SebastianJay/chECEckm8/(list of files, drawings)

Other design files:
schematics/master_board.ms14
