SebastianJay/chECEckm8/ccs-workspace/checkmate/board_state.h

/*
 * board_state.h
 *
 * Deals with reading from sensor network and determining
 * when a piece movement has been made.
 *
 *  Created on: Oct 18, 2016
 *      Author: Jay
 */

#ifndef BOARD_STATE_H_
#define BOARD_STATE_H_

/** Defines **/
#define BOARD_ROWS 8
#define BOARD_COLS 8
#define MOVES_BUFFER_LENGTH 8
#define MOVES_CHANGE_THRESHOLD 8
#define MOVES_CHANGE_BUFFER_WINDOW	10

#define MUX_SELECT1_PORT	GPIO_PORT_P5
#define MUX_SELECT1_PIN		GPIO_PIN5
#define MUX_SELECT2_PORT	GPIO_PORT_P5
#define MUX_SELECT2_PIN		GPIO_PIN4
#define MUX_SELECT3_PORT	GPIO_PORT_P4
#define MUX_SELECT3_PIN		GPIO_PIN7
#define MUX_SELECT4_PORT	GPIO_PORT_P4
#define MUX_SELECT4_PIN		GPIO_PIN5

#define MUX_READ1_PORT		GPIO_PORT_P4
#define MUX_READ1_PIN		GPIO_PIN4
#define MUX_READ2_PORT		GPIO_PORT_P4
#define MUX_READ2_PIN		GPIO_PIN2
#define MUX_READ3_PORT		GPIO_PORT_P4
#define MUX_READ3_PIN		GPIO_PIN0
#define MUX_READ4_PORT		GPIO_PORT_P6
#define MUX_READ4_PIN		GPIO_PIN1

#define TRUE 				1
#define FALSE 				0
#define ERROR 				-1
#define GAMEOVER_NO_MOVE	2
#define GAMEOVER_WITH_MOVE	3

#define STATUS_NORMAL		1
#define STATUS_INVALID		0

/** Typedefs **/
typedef struct {
	// row and col of piece location
	signed char r;
	signed char c;
	// flag for direction of change (piece coming off or on)
	char dir;

} piece_change;

typedef struct {
	// row and col of piece start location
	signed char rStart;
	signed char cStart;
	// row and col of piece end location
	signed char rEnd;
	signed char cEnd;
} piece_movement;

typedef struct {
	// most recent valid state
	char validState[BOARD_ROWS][BOARD_COLS];
	// buffer for current state of board
	char currentState[BOARD_ROWS][BOARD_COLS];
	// buffer for most recent read straight from sensor network
	char nextState[BOARD_ROWS][BOARD_COLS];
	// counters for each board space of number of frames state has changed
	char changeStateCounter[BOARD_ROWS][BOARD_COLS];
	char changeStateBuffer[BOARD_ROWS][BOARD_COLS][MOVES_CHANGE_BUFFER_WINDOW];
	char changeStateBufferIndex;

	// keep track of moves player has made
	piece_change moveList[MOVES_BUFFER_LENGTH];
	char moveListIndex;
} chess_board;

/** Globals **/
chess_board gBoardState;

/** Functions **/
// do any setup to read from the sensor network
void initSensors();

// compares nextState against currentState and update changeStateCounter
void updateChangeStateCounter();

// for changes that meet threshold, update currentState and optionally update moveList
void updateCurrentState(char updateMoveList);

// in the invalid state, compare currentState against validState and return true if identical
signed char isCurrentStateValid();
// update currentState with the given parameter
void updateCurrentStateWithMove(piece_movement move);
// transfer contents of currentState into validState
void copyCurrentStateIntoValid();

// sets the LED to the appropriate state (on if invalid, off if valid)
void setStatusLed(signed char status);

// examine moveList and return TRUE and write to *move if chess move detected, FALSE otherwise
// can also return ERROR if an invalid move is detected from MSP
signed char constructPieceMovement(piece_movement* move);

// read from sensor network into nextState
void readNextState();

#endif /* BOARD_STATE_H_ */
