SebastianJay/chECEckm8/ccs-workspace/checkmate/motors.h

/*
 * motors.h
 *
 * Deals with interfacing with the XY table motors and servo
 *
 *  Created on: Oct 19, 2016
 *      Author: Jay
 */

#ifndef MOTORS_H_
#define MOTORS_H_

#include "driverlib.h"
#include "board_state.h"

/** Defines **/
#define SERVO_DELAY_BETWEEN_PULSE 	24000	// low ticks between pulses, 20 ms
// according to datasheet the full range is spanned by 0.75 ms (900 ticks) and 2.25 ms (2700 ticks) pulses
// in practice it seems we need to stretch these out a bit further
#define SERVO_PULSE_WIDTH_1			2225	 // high ticks for engage, 1.5 ms
#define SERVO_PULSE_WIDTH_2			1175 // high ticks for disengage, 2.25 ms

// delays associated with motor components
#define ONE_SECOND_TICKS	12000000
#define SERVO_ENGAGE_DELAY	ONE_SECOND_TICKS * 3 / 2	// ticks after switching the servo state (1.5 s)
#define MOTOR_MOVE_DELAY	ONE_SECOND_TICKS / 2	// ticks after completing a motor movement (0.5 s)
#define MOTOR_AWAKE_DELAY	ONE_SECOND_TICKS / 250	// ticks after awaking motor so it can "boot" (4 ms)

#define MOTOR_SPEED_SLOW	0
#define MOTOR_SPEED_FAST	1

/** default (SLOW) motor values **/
// these values are derived to apply 6400 Hz square wave to STEP
#define X_STEP_TICKS 	938		// ticks to wait in high or low for x stepping
#define Y_STEP_TICKS 	938		// ticks to wait in high or low for y stepping

/** FAST motor values **/
#define X_STEP_TICKS_FAST	469
#define Y_STEP_TICKS_FAST	469

// STEPS_PER_SPACE = steps needed to travel one chess board space (3.75 in)
// to calculate this, choose an arbitrary step count and measure its corresponding distance
//  then use a ratio with your desired distance to find the required step count
#define STEPS_PER_SPACE			10196

#define STEPS_COLUMN_A 5098
#define STEPS_ROW_ONE 3739

// ports and pins for motor control
#define X_STEP_PORT		GPIO_PORT_P2
#define X_STEP_PIN		GPIO_PIN5
#define X_DIR_PORT		GPIO_PORT_P3
#define X_DIR_PIN		GPIO_PIN0
#define X_SLEEP_PORT	GPIO_PORT_P5
#define X_SLEEP_PIN		GPIO_PIN7

#define Y_STEP_PORT		GPIO_PORT_P2
#define Y_STEP_PIN		GPIO_PIN7
#define Y_DIR_PORT		GPIO_PORT_P2
#define Y_DIR_PIN		GPIO_PIN6
#define Y_SLEEP_PORT	GPIO_PORT_P5
#define Y_SLEEP_PIN		GPIO_PIN6

#define X_HOMING_BUTTON_PORT	GPIO_PORT_P6
#define X_HOMING_BUTTON_PIN		GPIO_PIN6

#define Y_HOMING_BUTTON_PORT	GPIO_PORT_P6
#define Y_HOMING_BUTTON_PIN		GPIO_PIN7

#define SERVO_SIGNAL_PORT	GPIO_PORT_P2
#define SERVO_SIGNAL_PIN	GPIO_PIN4

// macro functions
#define ABSVAL(x)		((x) >= 0 ? (x) : -(x))
#define MAXVAL(x, y)	((x) > (y) ? (x) : (y))

/** Structs **/
typedef struct {
	signed char r;
	signed char c;
} tableCursor;

/** Globals **/
tableCursor gTableCursor;
int gCaptureIndex;
int gSpeedSetting;

/** Functions **/
// do any setup to send commands to motor driver
void initMotors();

// use the servo to move the magnet into position
void engageMagnet();
// use the servo to move the magnet out of position
void disengageMagnet();

void moveToButtons();

// move table cursor to (0, 0), the bottom left corner
void moveToHome();
// move table cursor to (row, column), with option of using servo
void moveRC(int row, int column, int engage);

// execute 1 or 2 moves sent from the chess server using the motors, choosing to use corners intelligently
void process_moves(piece_movement move1, piece_movement move2);
// move from one location to another, with option of using servo to magnetically drag piece
//  useCorner determines whether to move between tiles
void move(piece_movement movement, int engage, int useCorner);
// helpers to accomplish move()
void moveX(int num_spaces);		// moves along the x axis (between columns)
void moveY(int num_spaces);		// moves along the y axis (between rows)
void moveXY(int x_num_spaces, int y_num_spaces); 	// moves diagonally (between col and row at once)
void moveHalfTile(int xdir, int ydir);		// moves a half tile in directions specified by signs of parameters
void stepX();		// sends STEP to x axis motor
void stepY();		// sends STEP to y axis motor

// DEBUG functions
// transitions between engaged and disengaged states forever
void debugServoLoop();
// does some simple motor movement
void debugMotorDemo();
// tests whether MSP can read from button
void debugButtonDemo();

#endif /* MOTORS_H_ */
