SebastianJay/chECEckm8/(commit log)

2016-09-21 prelim uart code from site
2016-10-24 uart hello world communication
2016-11-07 servo two state code
2016-11-12 change servo states to be 90 deg apart
2016-11-14 Added code for motor movement, need to work out kinks.
2016-11-14 work on motor control
2016-11-18 Added motor convenience code.
2016-11-19 refactor motor code
2016-11-19 adjust motor step frequency
2016-11-19 add sleep to motors
2016-11-19 tuning motor control
2016-11-19 add motor to corner code
2016-11-22 changes to uart comm to for usb serial to pins
2016-11-23 clean up uart comm code
2016-11-26 add pin mappings doc
2016-11-28 update pin doc
2016-11-28 add master board
    [master_board.ms14]
2016-11-30 homing switch demo
2016-12-01 update pcb design
    [master_board.ms14]
2016-12-02 update board schematic
    [master_board.ms14]
2016-12-11 Added a method to move to stop buttons.
2016-12-11 adjust motor axes
2016-12-11 Several motor changes ...
2016-12-11 new motor routing
2016-12-12 add status leds
2016-12-12 fixes for good MSP
    [game.py, motors.h, uart_comm.c]
2016-12-13 adjust motor speed
